blackmirag3/TheA-Maze-ingRace/yanming.jpg

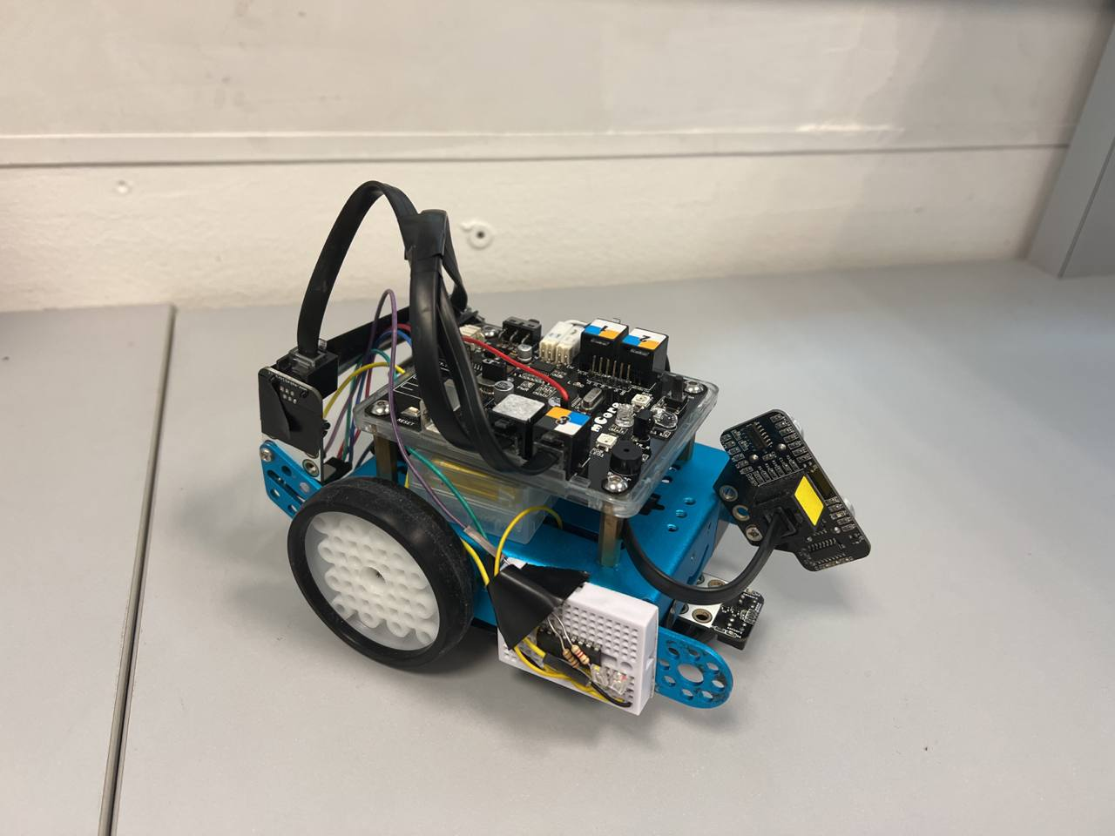
yanming.jpg
